P0ed/Modules/Mixer_v2/v1-notes.md

# Mixer notes — 7 November 2026

I came away liking both the instrument implied by this panel and Xcopper’s underlying model. I also came away with a clear list of things I would change. This iteration demonstrated that the pieces can be assembled into a complete, connected board. The next pass should give more attention to the analog layout, the behavior of the balanced interface, and the experience of playing the instrument.

The most useful thing Xcopper gave me was the ability to reuse actual routed circuits. BUF, MIX, OUT, and OP carry more knowledge than a schematic symbol: they contain the component choice, bypassing, geometry, and existing copper. Discovering those modules, inspecting their interfaces, and instantiating them with different labels and parameters worked well. The paired schematic/layout model also helped prevent a whole class of mismatches. That foundation feels worth developing.

The hardest engineering part was keeping the circuit, panel mechanics, and electrical conventions consistent at the same time. The panel specified positions and a visual vocabulary, but it did not completely specify an instrument. We had to establish what the switches did, which auxiliary input fed which bus, whether RETURN followed the phase switch, and precisely what “3.3 Vpp balanced” meant. Your corrections about the mirrored PCB and the header positions mattered. A board can look plausible while getting one of those relationships wrong.

## LED driver misunderstanding:

The most awkward circuit problem was the indicator system under the AD823A-and-1206 restriction. Two LEDs ended up using four dual op-amp packages for monitoring, rectification, and current drive, plus the shared reference amplifier. That is a substantial amount of circuitry for two lights. The ground-clamped half-wave stages and weighted summation give a way to detect both polarities without extra rectifier diodes, but they also introduce behavior that deserves measurement: recovery from saturation, startup, the zero-signal deadband, and response to small or fast signals. This is the circuit I would prototype separately first.

<!-- Should have just connected LED_DRIVE.V1/V2 to Pin 1/7 of `Base/OUT.xcb` Op-amp and call it a day -->

## MCP Flow friction:

The largest practical time sink was applying the design through very small MCP operations. The document advanced through roughly 460 editing revisions. Placing a native part and labeling its pins required separate calls. Copper was applied through 304 successful via/path operations, with an additional rejected attempt. Every successful edit returned another full design inspection. A lot of the work became managing revisions, handles, serialized geometry, and tool round trips.

## Autorouting helper:

I built a temporary C++ maze router to prepare the copper paths, then submitted them through Xcopper and checked the result with native DRC. The route tool itself did not solve the board’s routing problem. I also wrote a small DC nodal-analysis program against the resolved pin nets. Those helpers were useful, but I would prefer much less external machinery for this kind of task.

## MCP improvements:

My first MCP improvement would be an atomic batch-edit operation. It should accept a group of placements, labels, moves, vias, and paths, validate them together, and commit them as one transaction. The existing revision check is valuable and should stay at the transaction boundary. The batch should either succeed completely or report which operation failed without leaving a partially applied group. One undo step for a functional block would also make the result easier for you to review and revise.

I would let `place_part` accept pin labels directly, just as module placement already does. More generally, the API should make one meaningful design action possible in one request. “Place this resistor with this value, these nets, and these two view positions” is a natural unit of work.

My second priority would be compact mutation responses. Most edits only need to return the new revision, the affected objects, and any diagnostics. A complete inspection could remain available explicitly. Stable identifiers for native parts and copper would help too; revision validation can protect against concurrent edits without requiring every object address to be refreshed after every unrelated change. The current explicit units, layer indices, rotations, and read-only flags are good and should remain.

For routing, I would add a connection-level operation: connect this pad or copper island to that island, within specified layers, width, clearance, and via rules. It should understand existing copper and plane connections. The low-level polyline operation is still useful, but an agent should not have to reconstruct the entire obstacle and connectivity model to join two terminals safely. A proposal/dry-run mode would be particularly helpful: return the proposed copper, added vias, and resulting violations before committing it.

There was one revealing routing failure. A short LED connection was rejected by the finishing routine, then accepted when I reversed the order of the same polyline’s points. The final result passed DRC, but the error message did not explain the failing corner or repair. I would want the offending vertex, turn angle, available segment lengths, and attempted repair in that response. Geometrically equivalent requests should behave consistently, or explain why the finishing algorithm treats them differently.

The diagnostics need more actionable routing data. An unrouted finding currently gives a net name and a location, but I needed the two disconnected islands and their candidate terminals. Return the actual ratsnest endpoints, pad identities, layers, and whether a connection needs to reach a plane. Clearance findings could similarly include the measured and required distances as structured fields. That would turn diagnostics into inputs for the next operation instead of clues that require another search.

I would also add a native preview function. I generated an independent image from inspected geometry to examine placement and the planned routes. That helped, but a second renderer can reproduce an incorrect assumption. A preview from Xcopper’s own renderer, tagged with its revision and selected layers, would be much more useful. Small viewport commands such as fit-board and clear-selection would help as well. My attempt to clear selection with an empty `reveal_objects` request was rejected.

## File access issue:

The file-access model had another rough edge. I could edit and save an already-open document, but the MCP could not reopen it after closing because the AI workspace had not been configured. I eventually reopened it through normal macOS file opening. Some failed attempts came from the execution sandbox, so I would not attribute all of that friction to Xcopper. Still, a reopen operation that preserves the existing file grant, or a permission-status preflight, would make that round trip predictable without requesting broader folder access.

## Panel as a first-class citizen:

Within the app, I would make panel geometry a first-class reference. Importing the `.panel` file as a locked overlay, with explicit front/rear transforms and panel-to-board offsets, would remove a lot of avoidable reasoning. Control centers, connector nuts, pot bodies, lens barrels, and the panel-to-PCB spacing should all be inspectable. Copper clearance alone does not establish that the assembled hardware fits.

## Modules reuse:

I would give modules a little more flexibility while preserving their shared sources. A deliberate “fork this instance locally” operation would be useful when a reusable block is almost right but its placement or compensation needs adjustment. Pinning a design to particular module contents would also improve reproducibility. I like reuse; I want an old board to remain understandable when its library evolves.

Component ratings deserve structured fields. I put tolerance information into some value strings and documented capacitor voltage ratings and output-resistor power ratings separately. Those choices should travel with the components into the BOM. Likewise, relationships such as matched balanced legs, a sensitive summing node, or an LED-current return should be representable. The app need not make every analog decision, but it can preserve the decisions an engineer has made.

## Long summing nodes:

My strongest criticism of my own board is the placement of the summing resistors. Several sit near their switches or signal sources, leaving relatively long routes on the shared virtual-earth nodes. I would move those resistors toward the summing amplifiers and let the longer routes carry the buffered signals. Keeping the summing nodes and feedback loops compact is a more important next improvement than making every visible trace look tidy. I would also bring the detector RC networks closer to their corresponding amplifier inputs and reduce unnecessary crossings and vias.

## -

The balanced outputs deserve a focused review. Their two legs pass through different amplifier paths, with different feedback resistor values and compensation time constants. The DC gains agree with the intended conversion, but I would measure gain and phase agreement across frequency and with representative cable loads. I would prefer a purpose-designed balanced-interface module whose symmetry, output impedance, filtering, and load behavior are explicit.

There is a similar distinction in the verification. The saved and reopened board had zero native DRC violations, zero unrouted connections, zero schematic diagnostics, and zero module errors. The 192 calculated DC cases checked routing, auxiliary polarity, and level settings; additional calculations checked conversion gains and RETURN common-mode behavior. Those are useful results. The model used idealized op-amps with finite gain and excluded the nonlinear LED stages. It did not establish noise, distortion, stability, clipping recovery, or actual LED behavior. Those remain measurement work.

## Design manifest:

I would also improve my own delivery process. Much of the routing and analysis automation lived in temporary files. For the next iteration I would preserve the design manifest, analysis harness, and validation results with the project, so the work can be reproduced without reconstructing this conversation. I would spend more effort making the schematic tell the signal-flow story clearly, rather than relying so heavily on net labels and companion prose.

## -

As a product, I like the mixer’s identity. Four level controls, direct routing between MAIN and SEND, and polarity control on the auxiliary inputs give it a clear physical vocabulary. DC coupling makes those operations useful for control voltages as well as audio. The balanced interface extends that vocabulary to another part of the system. It feels like a playable routing instrument, and I would preserve that character.

The exclusive MAIN/SEND choice is central to that character. It also needs very clear labeling: moving a channel to SEND can remove it from MAIN completely. The auxiliary inputs’ fixed destinations and the phase switches should be equally obvious on the panel. I would give the connector pinout and nominal level convention a consistent home across the whole instrument family. The banana and balanced outputs represent the same buses at different voltage scales; that relationship should be easy to discover.

In my own version, I would change the four routing switches to three positions: MAIN / OFF / SEND. A center-off position gives each channel an immediate mute without losing its level setting. That is probably the most useful performance feature I would add for the least disruption to the panel’s repeated pattern.

I would replace the two auxiliary phase toggles with controls that continuously attenuate and invert around a center-zero position. The present switches give an exact sign change, but adjustable magnitude makes cancellation and feedback much easier to explore. The four main channel controls would remain simple level controls.

I would also want a dedicated RETURN level control. In my own case-mounted version, I would move the power inlet away from the performance surface and use that front-panel position for RETURN level. That assumes the case provides convenient access to power. It is a deliberate packaging tradeoff: the effects loop should have an immediately accessible wet-level adjustment.

For the indicators, I would make overload visible while keeping separate SEND and MAIN information. Brightness tells me that something is happening; it gives a weaker answer to how much headroom remains. In an unconstrained product revision I would allow simpler indicator circuitry using appropriate additional devices. The AD823A-only rule has an appealing uniformity for construction and stocking, but I would weigh that against the board area, power, and verification effort devoted to two LEDs.

I would keep the present six-layer board as a useful prototype platform and evaluate a four-layer version after measurements. The current stack follows the reusable analog modules and makes supply connectivity convenient. We have not established that the mixer’s performance needs six layers. I would make that decision from the resulting layout, return paths, assembly goals, and measured behavior.

The first thing I would do with the prototype is exercise the controls while measuring the two buses: silence, small bipolar DC, audio, summed overload, and realistic output loads. I would pay particular attention to the long summing nodes, balanced-leg agreement, and indicator recovery. Then I would revise placement around what those measurements reveal. That is the part of this design I am most interested in seeing next: how the clean-looking board behaves as an instrument under someone’s hands.
