P0ed/Modules/(list of files, drawings)

Other design files:
Base/BUF.pcb
Base/DG.pcb
Base/IOJacks.pcb
Base/MIX.pcb
Base/OPSS.pcb
Base/PWR4.pcb
Function/CORE.pcb
Function/Function4x4.pcb
Function/Function.pcb
Function/HOLDCORE.pcb
Mixer_v1/Mixer.pcb
Mixer_v2/Balanced.pcb
Mixer_v2/Base/LEDDRIVE.pcb
Mixer_v2/Base/OP.pcb
Mixer_v2/Base/OUT.pcb
Mixer_v2/Mixer.pcb
